robomaniac/Simblee-Door-Lock/Simblee-door-lock/hardware/90D41674-C179-4FC4-B1FD-2287EDF8CE94.jpeg

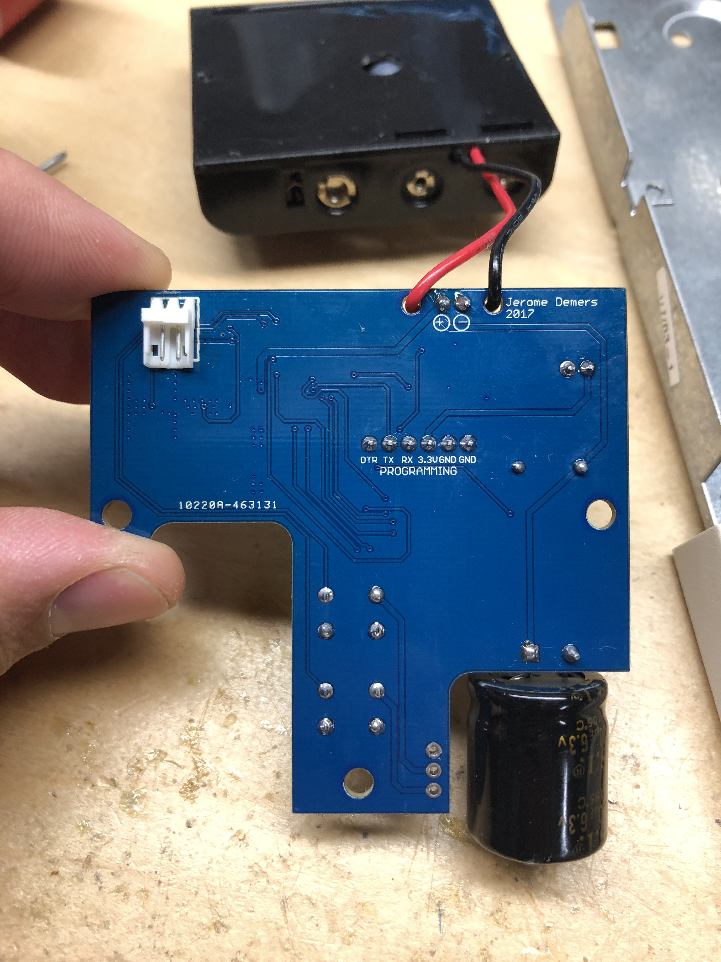
Simblee-door-lock/hardware/90D41674-C179-4FC4-B1FD-2287EDF8CE94.jpeg
