robomaniac/Simblee-Door-Lock/Simblee-door-lock/hardware/Simblee_door_lock.png

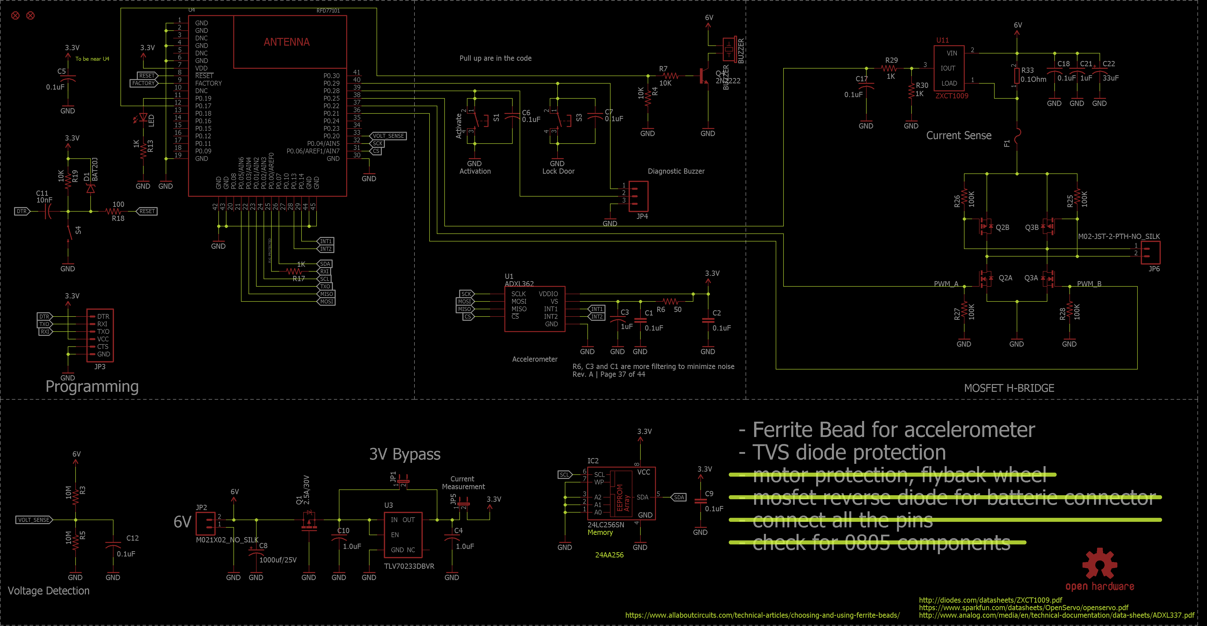
Simblee-door-lock/hardware/Simblee_door_lock.png
