robomaniac/Simblee-Door-Lock/Simblee-door-lock/hardware/Simblee_door_lock_PCB_bottom_layer.png

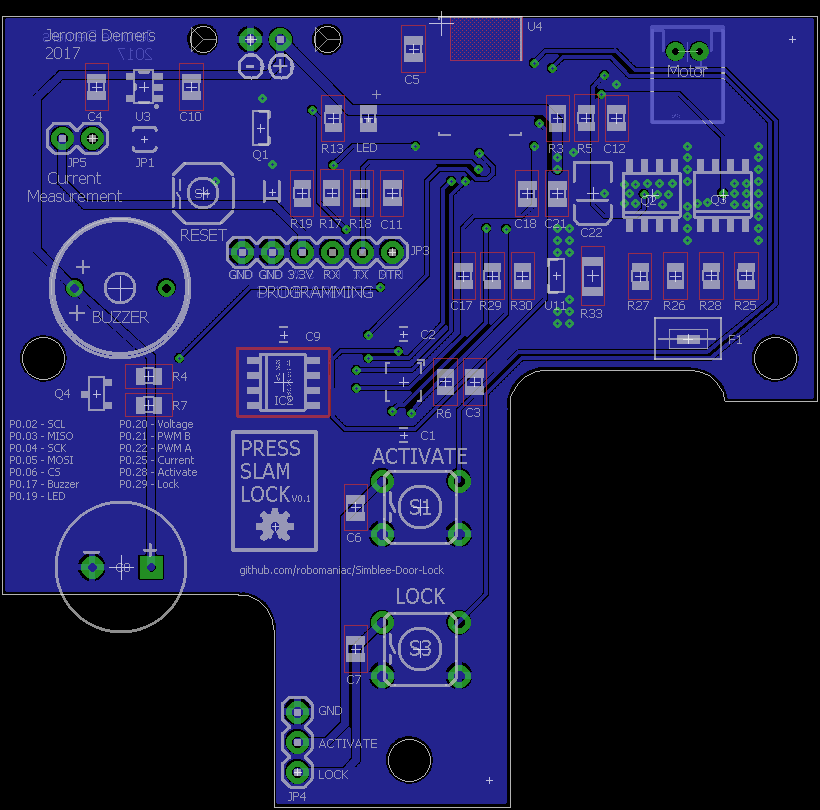
Simblee-door-lock/hardware/Simblee_door_lock_PCB_bottom_layer.png
