robomaniac/Simblee-Door-Lock/Simblee-door-lock/hardware/Simblee_door_lock_PCB_top_layer.png

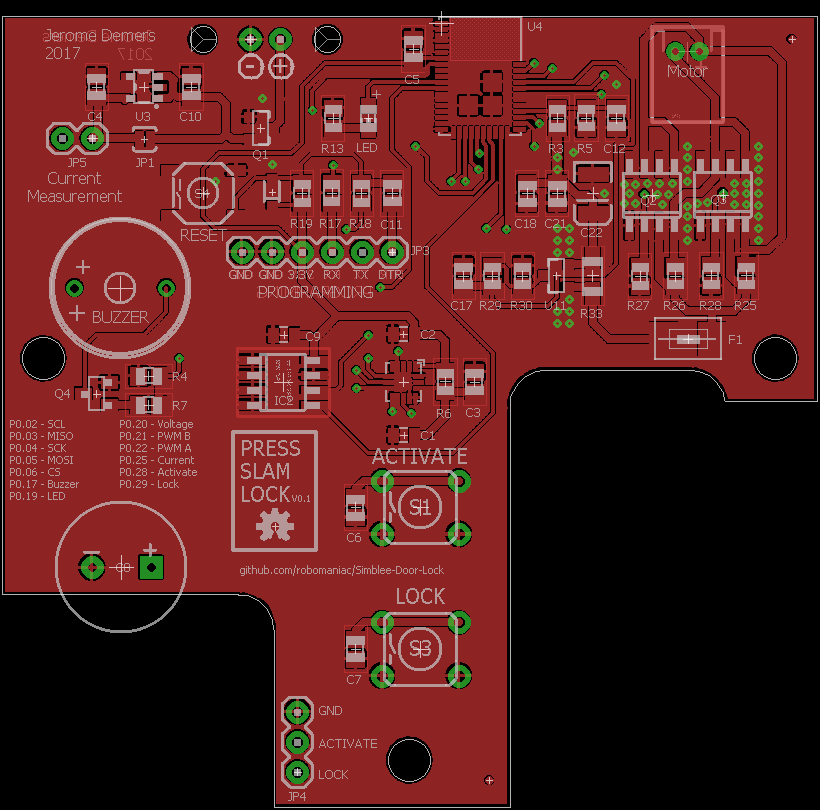
Simblee-door-lock/hardware/Simblee_door_lock_PCB_top_layer.png
