robomaniac/Simblee-Door-Lock/Simblee-door-lock/hardware/simblee_door_lock.pdf

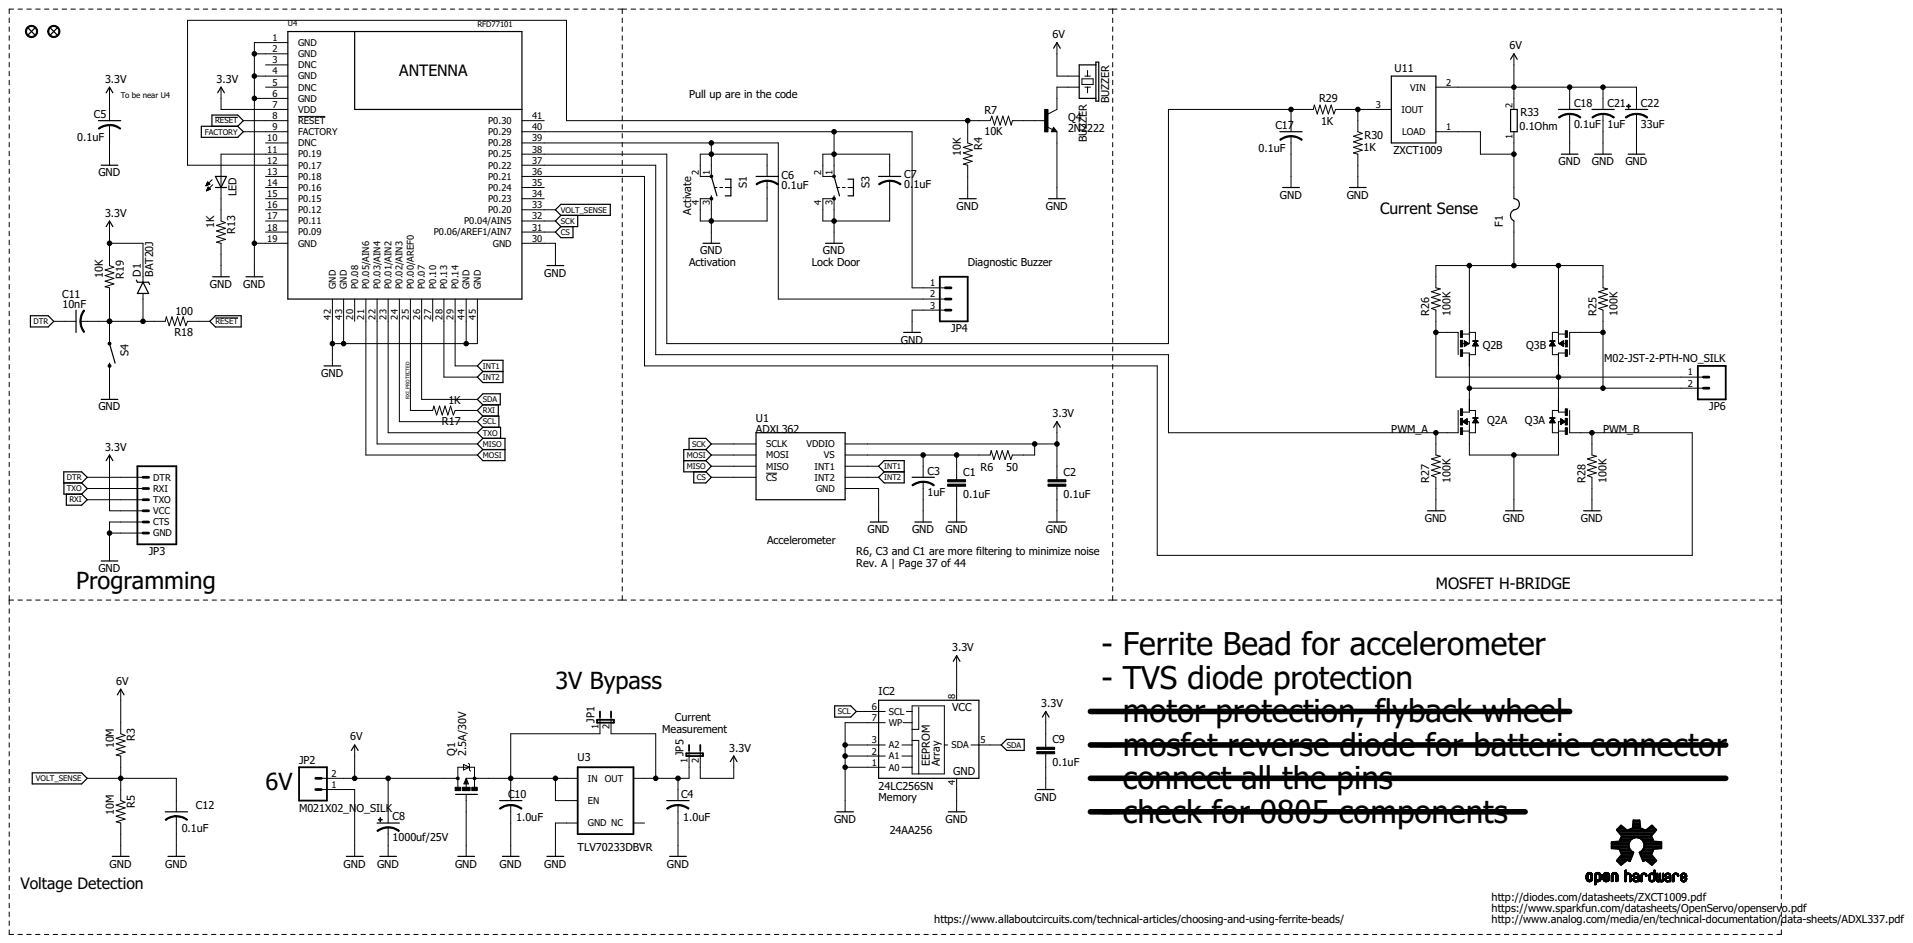
[picture p8: page 1]

Pull up are in the code

RESET | | DNC FACTORY P0.19 P0.17 P0.18 P0.16 P0.15 P0.12 P0.11 P0.09 GND
FACTORY | 9 10 | | 39 P0.29

R6, C3 and C1 are more filtering to minimize noise Rev. A | Page 37 of 44

- Ferrite Bead for accelerometer - TVS diode protection

- motor protection, flyback wheel - mosfet reverse diode for batterie connector - connect all the pins
