robomaniac/Simblee-Door-Lock/Simblee-door-lock/hardware/door_lock_2.brd

## EAGLE design Simblee-door-lock/hardware/door_lock_2.brd (2017-05-23)

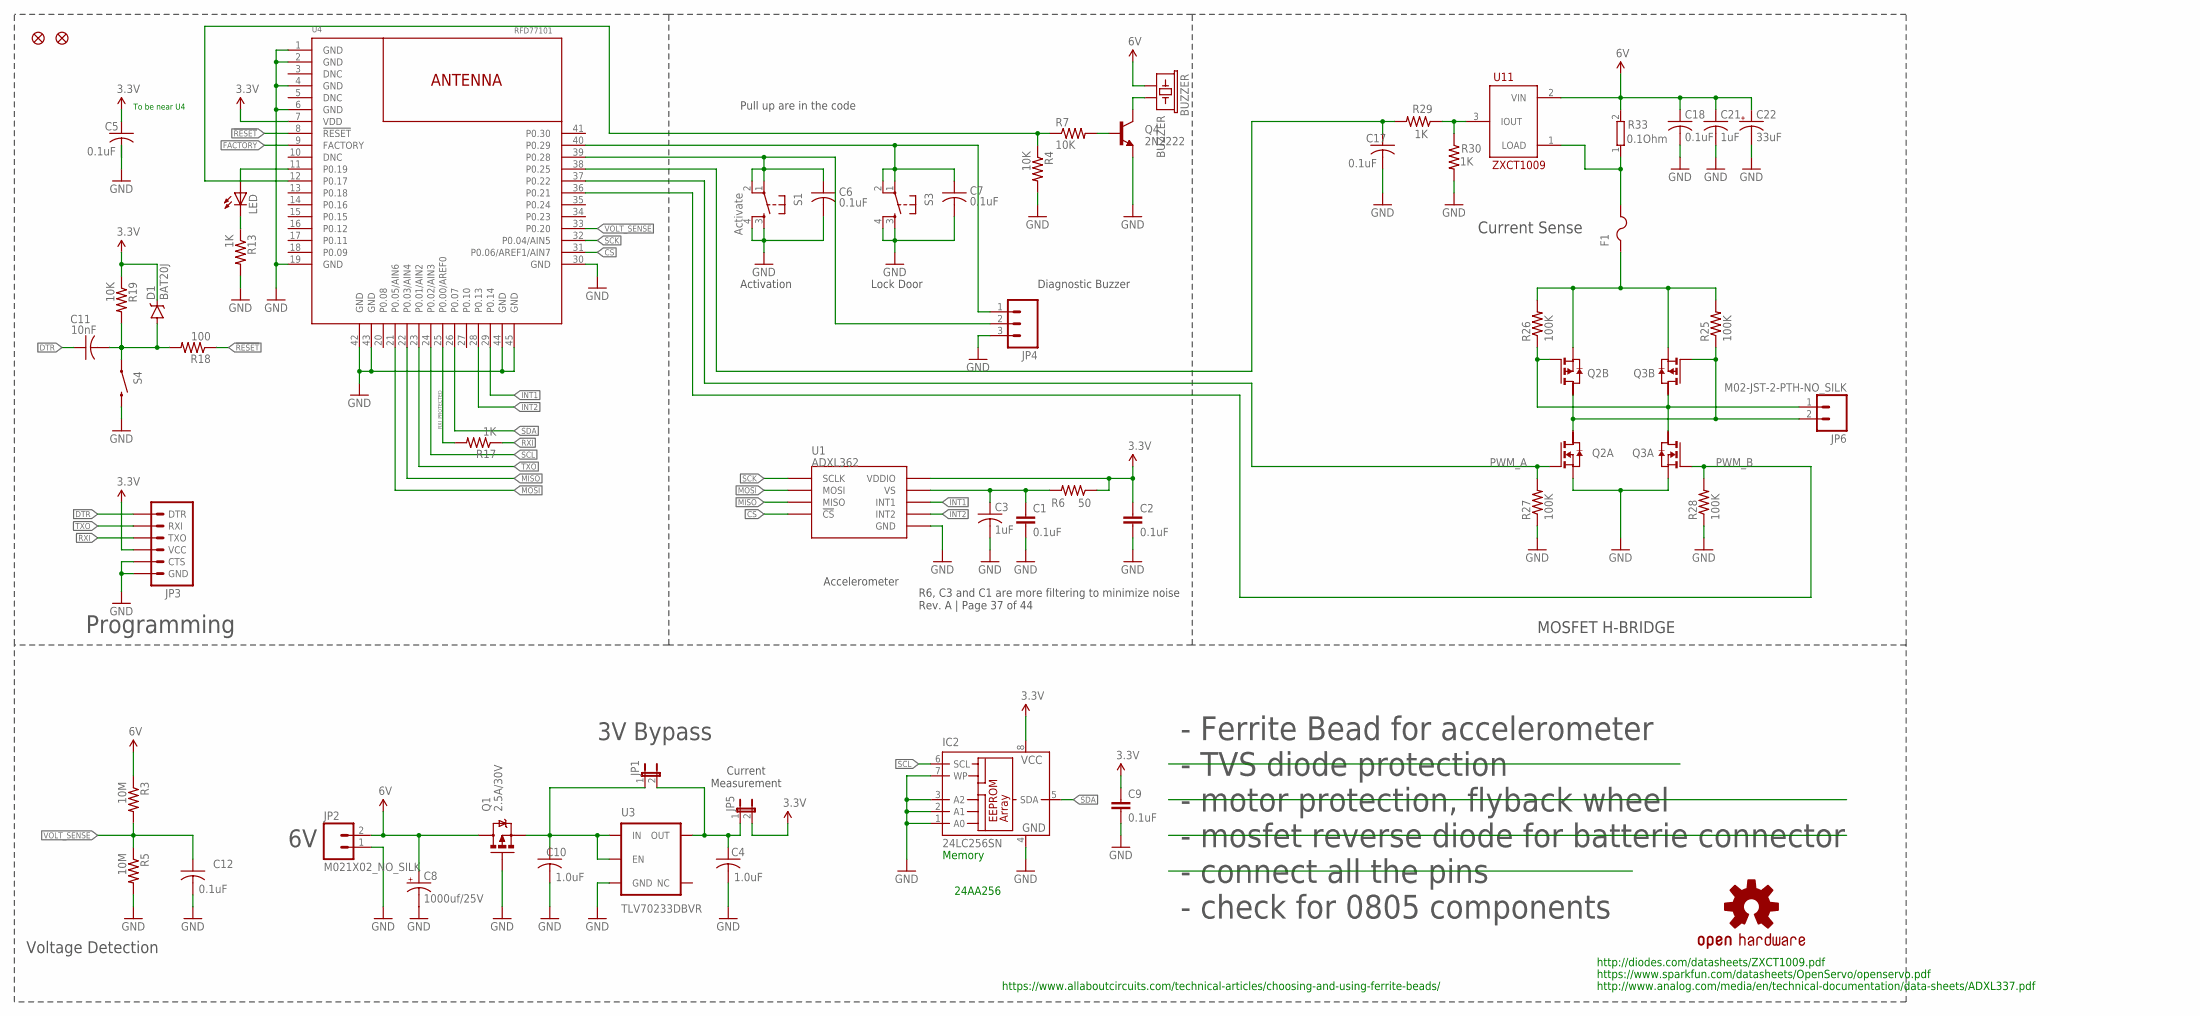
[picture p9: schematic door_lock_2.sch]

Parts:
BUZZER: BUZZER; BUZZER-12MM-NS
C1, C2, C9: 0.1uF; 0805
C3, C21: 1uF; C0805
C4, C10: 1.0uF; C0805
C5, C6, C7, C12, C17, C18: 0.1uF; C0805
C8: 1000uf/25V; CPOL-RADIAL-1000UF-25V-KIT
C11: 10nF; C0805
C22: 33uF; EIA3528
D1: BAT20J; SOD-323
F1: PTCFUSE-1812; 1812
IC2: 24LC256SN; SO-08
JP1: JUMPER-2SMD-NO; SJ_2S-NO
JP2: M021X02_NO_SILK; 1X02_NO_SILK
JP3: ARDUINO_SERIAL_PROGRAMPTH; 1X06
JP4: M03PTH; 1X03
JP5: JUMPER-2PTH; 1X02
JP6: M02-JST-2-PTH-NO_SILK; JST-2-PTH-NS
JP9, JP10: FIDUCIALUFIDUCIAL; MICRO-FIDUCIAL
LED: LEDCHIP-LED0805; CHIP-LED0805
Q1: 2.5A/30V; SOT23-3
Q2, Q3: PN_MOSFET-SO8; SO8
Q4: 2N2222; SOT23
R3, R5: 10M; R0805
R4, R7, R19: 10K; R0805
R6: 50; R0805
R13, R17, R29, R30: 1K; R0805
R18: 100; R0805
R25, R26, R27, R28: 100K; R0805
R33: 0.1Ohm; R1206W
S1: Activate; TACTILE-PTH
S3: TAC_SWITCHPTH; TACTILE-PTH
S4: SWITCH-MOMENTARY-2SMD; TACTILE-SWITCH-SMD
U1: ADXL362
U3: TLV70233DBVR; SOT23-5
U4: RFD77101
U11: ZXCT1009; SOT23-3
U$3: OSHW-LOGOS; OSHW-LOGO-S

Connections:
3.3V: C2.1, C5.1, C9.1, D1.C, IC2.8 (VCC), JP3.4 (VCC), JP5.2, R6.1, R19.1, U1.P$1 (VDDIO), U4.7 (VDD)
6V: BUZZER.+ (1), C8.+, C18.1, C21.1, C22.A (+), JP2.2, Q1.3 (D), R3.1, R33.2, U11.2 (VIN)
!RESET: R18.1, U4.8 (!RESET!)
ACTIVATE: C6.1, JP4.2, S1.1, S1.2, U4.39 (P0.28)
BUZZER: R4.1, R7.1, U4.12 (P0.17)
CS: U1.P$8 (!CS), U4.31 (P0.06/AREF1/AIN7)
CURSENSE: C17.1, R29.2, U4.38 (P0.25)
DTR: C11.1, JP3.1 (DTR)
FACTORY: U4.9 (FACTORY)
GND: C1.2, C2.2, C3.2, C4.2, C5.2, C6.2, C7.2, C8.-, C9.2, C10.2, C12.2, C17.2, C18.2, C21.2, C22.C (-), IC2.1 (A0), IC2.2 (A1), IC2.3 (A2), IC2.4 (GND), IC2.7 (WP), JP2.1, JP3.5 (CTS), JP3.6 (GND), JP4.3, Q1.1 (G), Q2.1 (S), Q3.1 (S), Q4.2 (E), R4.2, R5.2, R13.2, R27.1, R28.1, R30.2, S1.3, S1.4, S3.3, S3.4, S4.3 (2), U1.P$12 (GND), U1.P$13 (GND), U1.P$16 (GND), U3.2 (GND), U4.1 (GND), U4.2 (GND), U4.4 (GND), U4.6 (GND), U4.19 (GND), U4.30 (GND), U4.42 (GND), U4.43 (GND), U4.44 (GND), U4.45 (GND)
INT1: U1.P$11 (INT1), U4.29 (P0.14)
INT2: U1.P$9 (INT2), U4.28 (P0.13)
LOCK: C7.1, JP4.1, S3.1, S3.2, U4.40 (P0.29)
MISO: U1.P$7 (MISO), U4.22 (P0.03/AIN4)
MOSI: U1.P$6 (MOSI), U4.21 (P0.05/AIN6)
MOTOR_OUT_A: JP6.1, Q2.4 (G), Q3.5 (D), Q3.7 (D), R26.1
MOTOR_OUT_B: JP6.2, Q2.5 (D), Q2.7 (D), Q3.4 (G), R25.1
unnamed: C4.1, JP1.2, JP5.1, U3.5 (OUT)
unnamed: F1.2, R33.1, U11.1 (LOAD)
unnamed: C1.1, C3.1, R6.2, U1.P$14 (VS)
unnamed: Q4.1 (B), R7.2
unnamed: BUZZER.- (2), Q4.3 (C)
unnamed: C11.2, D1.A, R18.2, R19.2, S4.1
unnamed: LED.C, R13.1
unnamed: F1.1, Q2.3 (S), Q3.3 (S), R25.2, R26.2
unnamed: R29.1, R30.1, U11.3 (IOUT)
P0.10: LED.A, U4.11 (P0.19)
PWM_A: Q2.2 (G), R27.2, U4.37 (P0.22)
PWM_B: Q3.2 (G), R28.2, U4.36 (P0.21)
RXI: JP3.3 (TXO), R17.1
RXI_PROTECTED: R17.2, U4.25 (P0.00/AREF0)
SCK: U1.P$4 (SCLK), U4.32 (P0.04/AIN5)
SCL: IC2.6 (SCL), U4.24 (P0.02/AIN3)
SDA: IC2.5 (SDA), U4.26 (P0.07)
TXO: JP3.2 (RXI), U4.23 (P0.01/AIN2)
VIN1: C10.1, JP1.1, Q1.2 (S), U3.1 (IN), U3.3 (EN)
VOLT_SENSE: C12.1, R3.2, R5.1, U4.33 (P0.20)

Notes on the sheet:
Accelerometer
Activation
Diagnostic Buzzer
Lock Door
Memory
Current Measurement
To be near U4
Programming
MOSFET H-BRIDGE
Current Sense
Voltage Detection
https://www.sparkfun.com/datasheets/OpenServo/openservo.pdf
http://diodes.com/datasheets/ZXCT1009.pdf
- Ferrite Bead for accelerometer - TVS diode protection - motor protection, flyback wheel - mosfet reverse diode for batterie connector - connect all the pins - check for 0805 components
http://www.analog.com/media/en/technical-documentation/data-sheets/ADXL337.pdf
https://www.allaboutcircuits.com/technical-articles/choosing-and-using-ferrite-beads/
24AA256
3V Bypass
Pull up are in the code
R6, C3 and C1 are more filtering to minimize noise Rev. A | Page 37 of 44

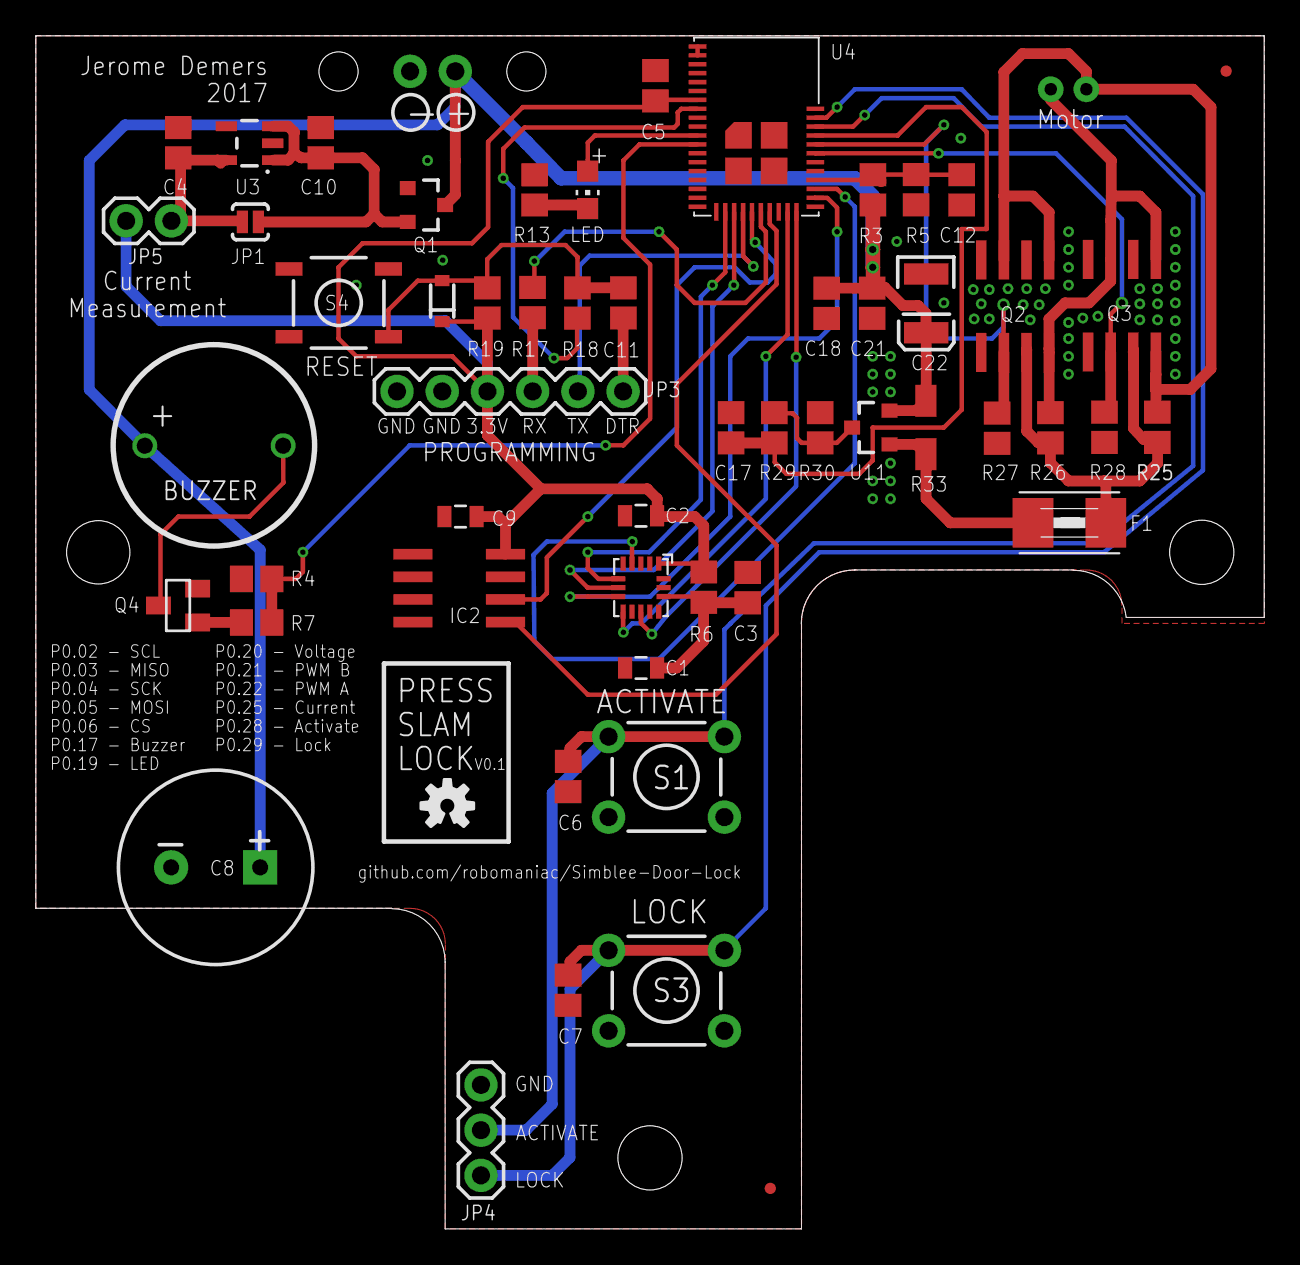
[picture p10: board door_lock_2.brd from above]

Board: 2 copper layers, 69.0 x 67.0 mm, 57 parts (1 on the bottom side), 36 nets.
