robomaniac/Simblee-Door-Lock/(commit log)

2017-05-23 added hardware folder with schematic
    [door_lock_2.brd, door_lock_2.sch]
2017-05-23 updated schematic and PCB pictures
2018-07-22 Pictures of the PCB
