robomaniac/Simblee-Door-Lock/Simblee-door-lock/hardware/29112A4F-87B5-44AE-8199-6A1162096EBD.jpeg

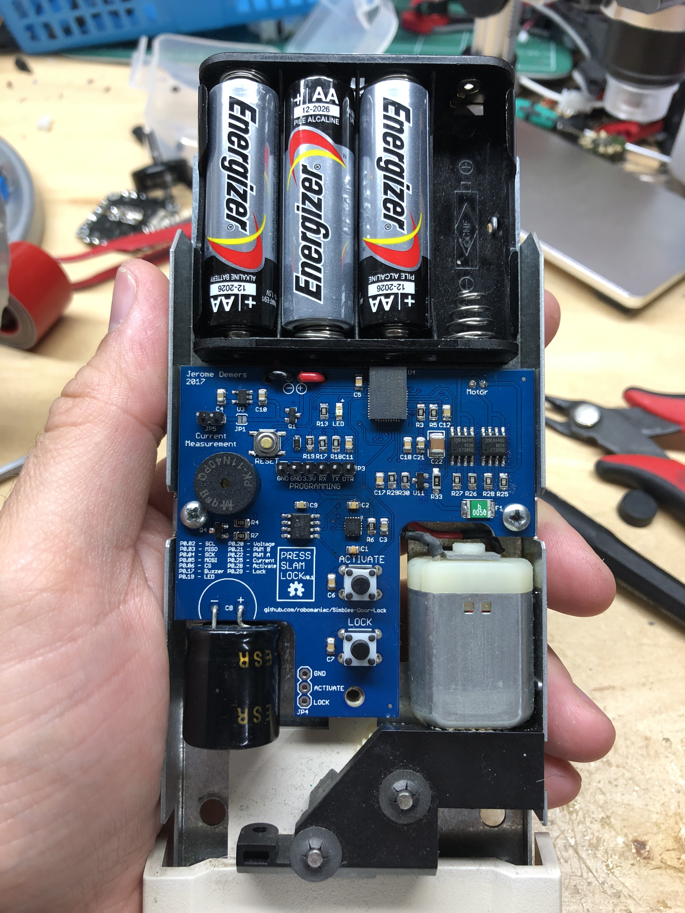
Simblee-door-lock/hardware/29112A4F-87B5-44AE-8199-6A1162096EBD.jpeg
