robomaniac/Simblee-Door-Lock/Simblee-door-lock/hardware/9BBFA7B1-5E68-4401-9D5A-D05956A8AC02.jpeg

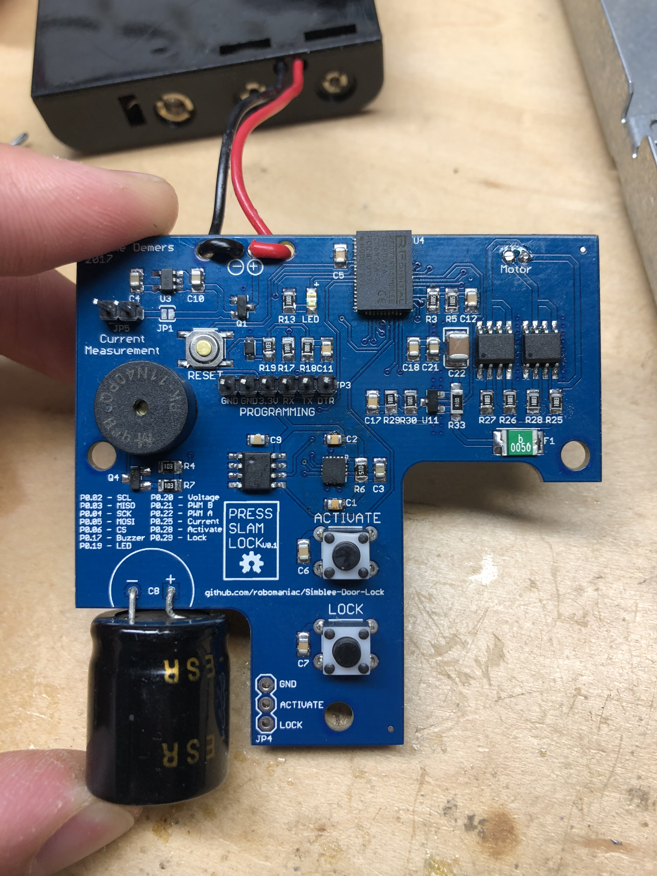
Simblee-door-lock/hardware/9BBFA7B1-5E68-4401-9D5A-D05956A8AC02.jpeg
