robomaniac/Simblee-Door-Lock/Simblee-door-lock/hardware/C8659290-0119-4FE6-8023-CD874A5E3AB2.jpeg

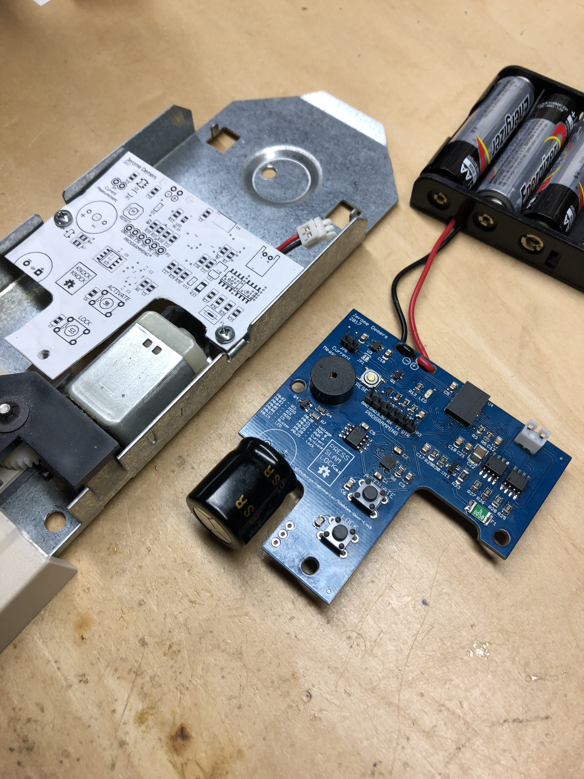
Simblee-door-lock/hardware/C8659290-0119-4FE6-8023-CD874A5E3AB2.jpeg
